LarryVan-engin/PJC_MIC/FOX M4 Possible Update (Hardware).drawio.pdf

IC mạch sạc (X) Single-cell Li-ion charger Sạc pin receiver qua USB-C

Pin Li Po 5000 mAh

Cổng sạc USB C 5V

MCU ESP32 (X) Bluetooth audio SoC / DSP processor MCU phụ xử lý Bluetooth audio, DSP, ....

MCU ESP32P4 Bluetooth audio SoC / DSP processor MCU chính xử lý DSP, mix, control

trung tâm

IC UHF #1 (X)
IC cho wireless microphone/UHF audio UHF FM demodulator, compandor/expander, squelch, audio output

IC UHF #2 (X)
IC cho wireless microphone/UHF audio UHF FM demodulator, compandor/expander, squelch, audio output

Khối nguồn

Power Source +3v3

MICROPHONE TX CH1 | MICROPHONE TX CH2

UHF RF

audio analog

UHF RF

Khối xử lý đầu vào từ 2 Microphone

IC Summing + Buffering (X) LM358-class dual op-amp Summing và Buffering 2 kênh audio từ KT065x

Power Source +3v3 | Kênh giao tiếp MCU #2

audio analog

BT A2DP BR/EDR

Khối xử lý bluetooth/ Hiển thị/ Nút bấm

Power Source +3v3

Bus giao tiếp với MCU ESP32P4

Thiết bị kết nối bluetooth (Điện thoại/ Máy tính bảng/ Laptop,...)

Khối xử lý đầu ra

Power Source +3v3

IC GAIN #1 (X) 3-Vrms cap-less line driver Driver output analog cho các cổng out (6.5mm, 3.5mm, XLR)

IC GAIN #2 (X) 3-Vrms cap-less line driver Driver output analog cho các cổng out (6.5mm, 3.5mm, XLR) Khối xử lý XLR

TS 6.35mm | AUX 3.5mm

Kênh giao tiếp MCU #2

Mode button Back Button ON/OFF Button

Encoder
(nút volume)

LCD Driver (X) LCD segment driver Drive LCD hiển thị

OLED module

Bus giao tiếp với MCU ESP32P4

Nút chọn channel 1 Nút chọn channel 2 Nút chọn channel 3 Nút chọn channel 4

SD Card
(Lưu file nhạc dưới dạng mp3 để phát)

Lưu ý: 1. Đây là sơ đồ khối các component nâng cấp, thay đổi trong phiên bản mới. 2. Các chỗ đánh dấu (X) là các IC chưa chọn để đưa vào, có thể sử dụng cùng loại với version trước. 3. khối XLR sẽ được thiết kế sau (hiện tại chỉ tham khảo).

SDMMC

Các cập nhật mới: 1. Thay đổi MCU, chuyển từ 2 con MV Silicon BP1548 sang MCU ESP32 (phụ, xử lý kết nối bluetooth) và MCU ESP32P4 Dual Core (chính, xử lý DSP). 2. Thay đổi nâng cấp mạch nguồn, sử dụng PIN 5000 mAh thay cho pin 3400 mAh cũ. 3. Nâng cấp OLED rộng hơn, có cảm ứng, đóng vai trò điều khiển thay vì chỉ hiển thị như phiên bản cũ. 4. Cập nhật các nút bấm mới, vẫn giữ như yêu cầu của khách hàng đề phòng trường hợp cảm ứng hư thì người dùng cũng có thể sử dụng được. 5. Thêm khe cắm SD card để có thể stream nhạc từ SD card. 6. Nâng cấp ra cả 3 chân AUX 3.5mm, TS 6.35mm và XLR.

Khối xử lý XLR

IC GAIN #3 (X) 3-Vrms cap-less line driver Driver output analog cho các cổng out (6.5mm, 3.5mm, RAC)

XLR Female 3-pin

Power Source +3v3

IC Balanced Driver (X) DRV134 hoặc THAT1646 Chuyển single-ended → differential.
