LarryVan-engin/PJC_MIC/FOX_M4_Block_Diagram.drawio.pdf

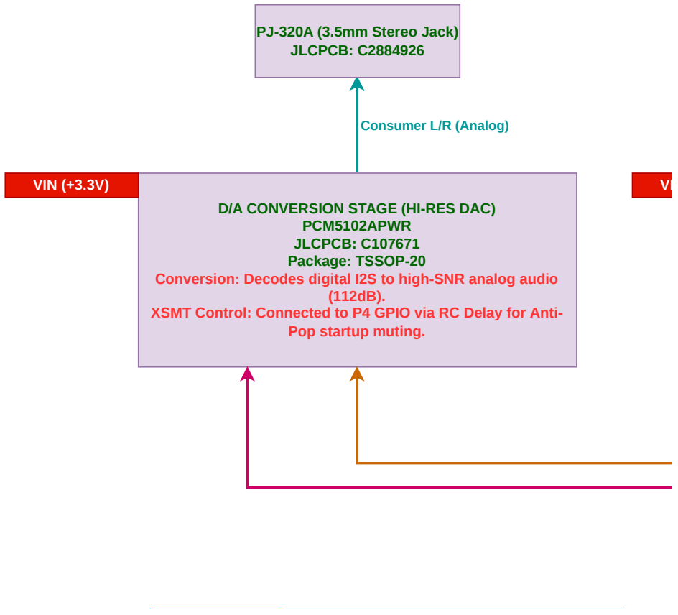
[picture p1: figure]
Consumer L/R (Analog); D/A CONVERSION STAGE (HI-RES DAC) PCM5102APWR JLCPCB: C107671 Package: TSSOP-20; Pop startup muting.; VIN (+3.3V); PJ-320A (3.5mm Stereo Jack) JLCPCB: C2884926

Conversion: Decodes digital I2S to high-SNR analog audio

XSMT Control: Connected to P4 GPIO via RC Delay for Anti-

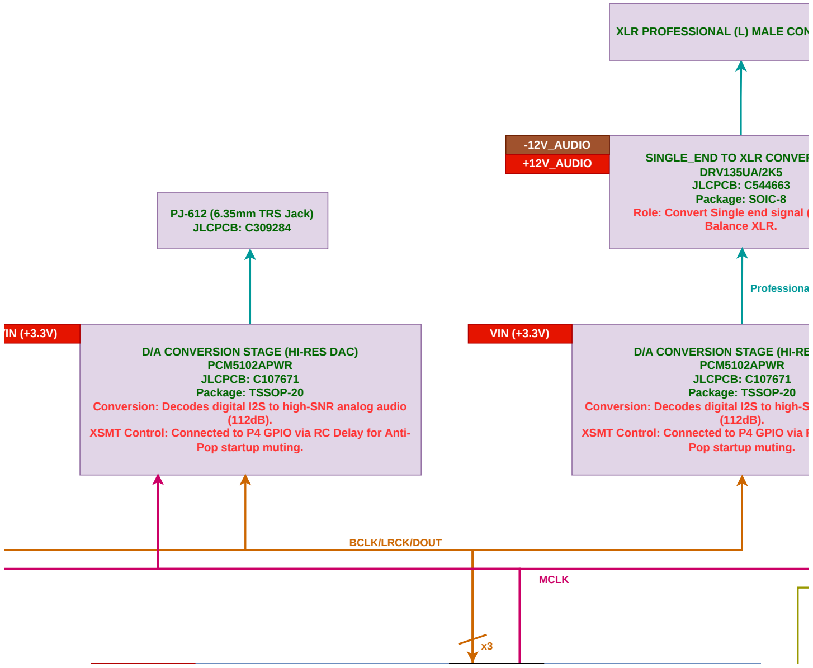
[picture p2: figure]
D/A CONVERSION STAGE (HI-RES DAC) PCM5102APWR JLCPCB: C107671 Package: TSSOP-20; Pop startup muting.; D/A CONVERSION STAGE (HI-RE PCM5102APWR JLCPCB: C107671 Package: TSSOP-20; VIN (+3.3V); PJ-612 (6.35mm TRS Jack) JLCPCB: C309284; SINGLE_END TO XLR CONVER DRV135UA/2K5 JLCPCB: C544663 Package: SOIC-8 Role: Convert Single end signal ( Balance XLR.; XLR PROFESSIONAL (L) MALE CON; Professiona; BCLK/LRCK/DOUT; MCLK; -12V_AUDIO +12V_AUDIO

Conversion: Decodes digital I2S to high-SNR analog audio

XSMT Control: Connected to P4 GPIO via RC Delay for Anti-

Conversion: Decodes digital I2S to high-S

XSMT Control: Connected to P4 GPIO via R

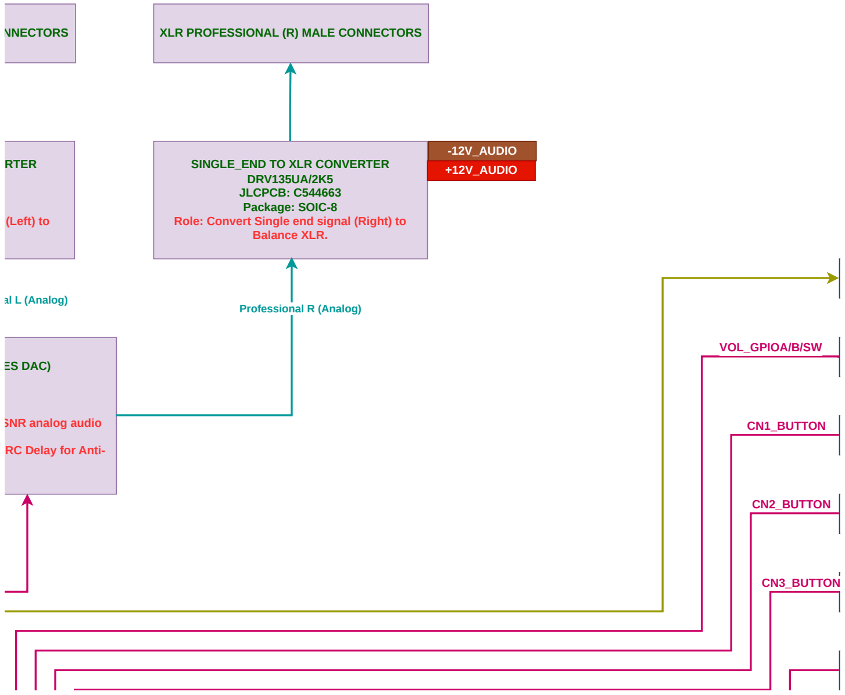
[picture p3: figure]
ES DAC); SNR analog audio; RC Delay for Anti-; RTER; (Left) to; NNECTORS; al L (Analog); VOL_GPIOA/B/SW; CN1_BUTTON; CN2_BUTTON; CN3_BUTTON; SINGLE_END TO XLR CONVERTER DRV135UA/2K5 JLCPCB: C544663 Package: SOIC-8; Balance XLR.; XLR PROFESSIONAL (R) MALE CONNECTORS; Professional R (Analog); -12V_AUDIO +12V_AUDIO

Role: Convert Single end signal (Right) to

SPI LCD Display 1.8 inch

Volume Button (Rotary Encoder)

Channel 1 button

Channel 2 button

Channel 3 button

Channel 4 button

VIN (+3.3V)

VIN (+3.3V)

VIN (+3.3V)

VIN (+3.3V)

VIN (+3.3V)

VIN (+3.3V)

SIGNAL LEGEND:

I2S (Audio Digital)

UART/USB (inter-MCU command)

Analog audio

Power rail

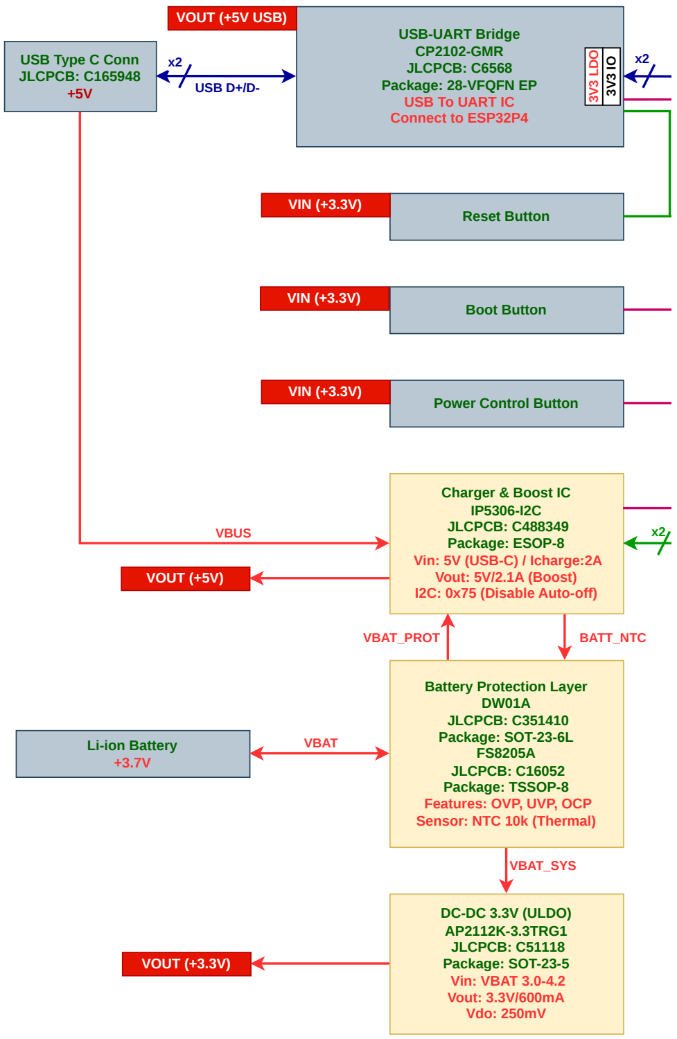
[picture p4: figure]
BATT_NTC; Charger & Boost IC IP5306-I2C JLCPCB: C488349 Package: ESOP-8 Vin: 5V (USB-C) / Icharge:2A Vout: 5V/2.1A (Boost) I2C: 0x75 (Disable Auto-off); DC-DC 3.3V (ULDO) AP2112K-3.3TRG1 JLCPCB: C51118 Package: SOT-23-5 Vin: VBAT 3.0-4.2 Vout: 3.3V/600mA Vdo: 250mV; VBAT_PROT; VBAT_SYS; Battery Protection Layer DW01A JLCPCB: C351410 Package: SOT-23-6L FS8205A JLCPCB: C16052 Package: TSSOP-8 Features: OVP, UVP, OCP Sensor: NTC 10k (Thermal); USB-UART Bridge CP2102-GMR JLCPCB: C6568 Package: 28-VFQFN EP USB To UART IC Connect to ESP32P4; VBUS; USB Type C Conn JLCPCB: C165948 +5V; Reset Button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

SPI (flash, display)

GPIO / interrupt

RF (UHF wireless)

I2C (control)

5V to 12V Rail
TPS65131RGER
JLCPCB: C87663
Package: QFN-24
Vin: +5V0
Vout: + 12V0

VOUT (+5V)

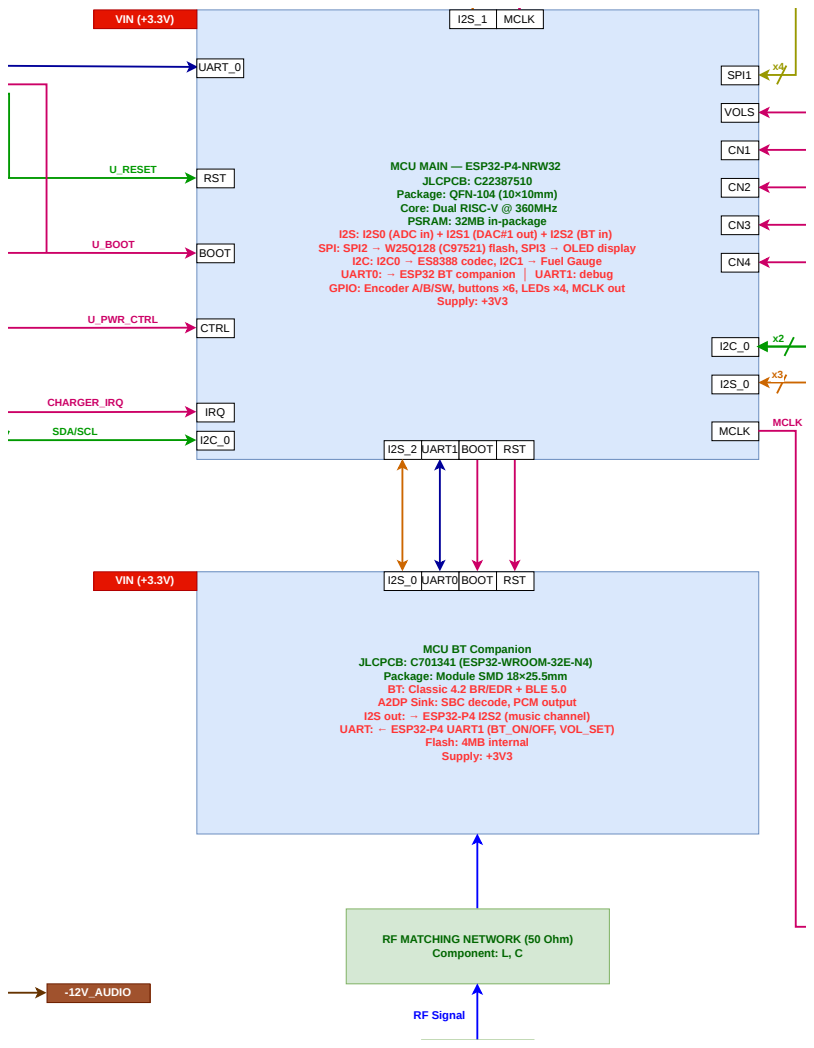
[picture p5: page 8]
Supply: +3V3; Flash: 4MB internal Supply: +3V3; I2S_2 UART1 BOOT RST; I2S_0 UART0 BOOT RST; U_RESET; U_BOOT; U_PWR_CTRL; SDA/SCL; -12V_AUDIO; CTRL; BOOT; RST; CHARGER_IRQ; IRQ; UART_0; MCLK; Component: L, C; RF Signal; SPI1; VOLS; VIN (+3.3V)

MCU MAIN — ESP32-P4-NRW32
JLCPCB: C22387510
Package: QFN-104 (10×10mm)
Core: Dual RISC-V @ 360MHz
PSRAM: 32MB in-package

I2S: I2S0 (ADC in) + I2S1 (DAC#1 out) + I2S2 (BT in)
SPI: SPI2 → W25Q128 (C97521) flash, SPI3 → OLED display
I2C: I2C0 → ES8388 codec, I2C1 → Fuel Gauge
UART0: → ESP32 BT companion │ UART1: debug
GPIO: Encoder A/B/SW, buttons ×6, LEDs ×4, MCLK out

MCU BT Companion

JLCPCB: C701341 (ESP32-WROOM-32E-N4)
Package: Module SMD 18×25.5mm
BT: Classic 4.2 BR/EDR + BLE 5.0
A2DP Sink: SBC decode, PCM output
I2S out: → ESP32-P4 I2S2 (music channel)
UART: ← ESP32-P4 UART1 (BT_ON/OFF, VOL_SET)

RF MATCHING NETWORK (50 Ohm)

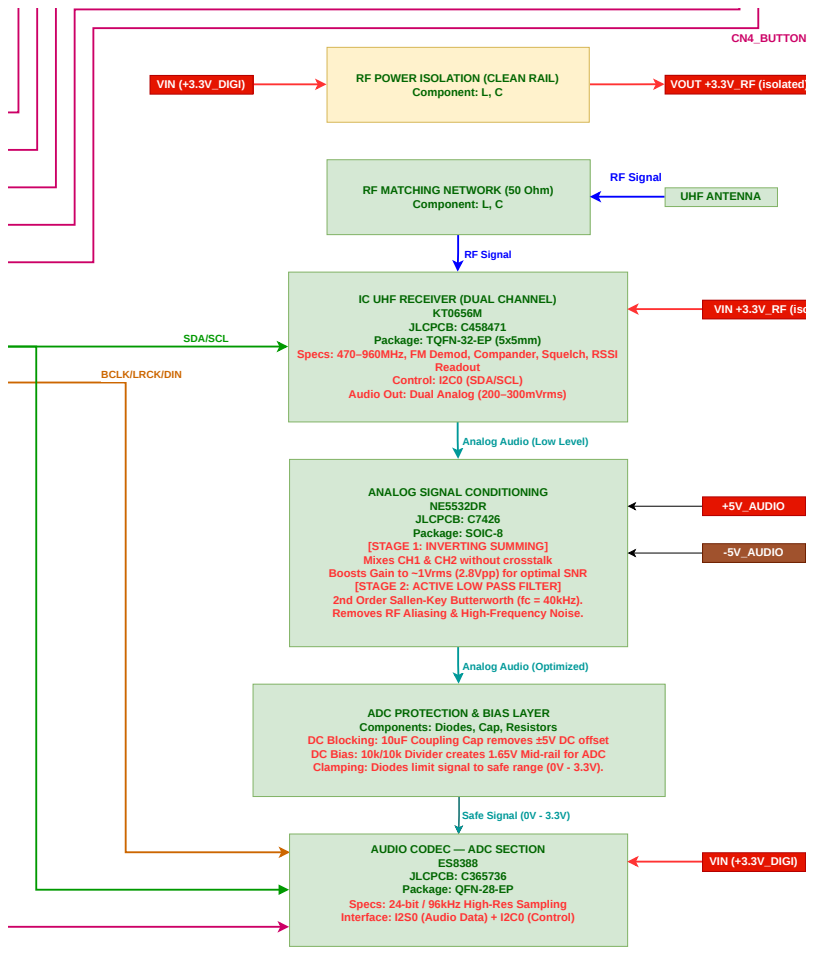
[picture p6: page 9]
Component: L, C; VIN (+3.3V_DIGI); VOUT +3.3V_RF (isolated); RF Signal; UHF ANTENNA; KT0656M JLCPCB: C458471 Package: TQFN-32-EP (5x5mm); Readout; VIN +3.3V_RF (iso; SDA/SCL; NE5532DR JLCPCB: C7426 Package: SOIC-8; Safe Signal (0V - 3.3V); +5V_AUDIO; -5V_AUDIO; ES8388 JLCPCB: C365736 Package: QFN-28-EP; CN4_BUTTON

RF POWER ISOLATION (CLEAN RAIL)

RF MATCHING NETWORK (50 Ohm)

IC UHF RECEIVER (DUAL CHANNEL)

Specs: 470–960MHz, FM Demod, Compander, Squelch, RSSI

BCLK/LRCK/DIN

Control: I2C0 (SDA/SCL)

Audio Out: Dual Analog (200–300mVrms)

Analog Audio (Low Level)

ANALOG SIGNAL CONDITIONING

[STAGE 1: INVERTING SUMMING]
Mixes CH1 & CH2 without crosstalk
Boosts Gain to ~1Vrms (2.8Vpp) for optimal SNR
[STAGE 2: ACTIVE LOW PASS FILTER]
2nd Order Sallen-Key Butterworth (fc = 40kHz).
Removes RF Aliasing & High-Frequency Noise.

Analog Audio (Optimized)

ADC PROTECTION & BIAS LAYER
Components: Diodes, Cap, Resistors

DC Blocking: 10uF Coupling Cap removes ±5V DC offset
DC Bias: 10k/10k Divider creates 1.65V Mid-rail for ADC
Clamping: Diodes limit signal to safe range (0V - 3.3V).

AUDIO CODEC — ADC SECTION

Specs: 24-bit / 96kHz High-Res Sampling
Interface: I2S0 (Audio Data) + I2C0 (Control)

d)

olated)

Vout: +-12V0
Fsw: 250 kHz (Fixed)
Type: Charge Pump Inverter

BLE ANTENNA
+12V_AUDIO
