LarryVan-engin/PJC_MIC/Fox M4.pdf

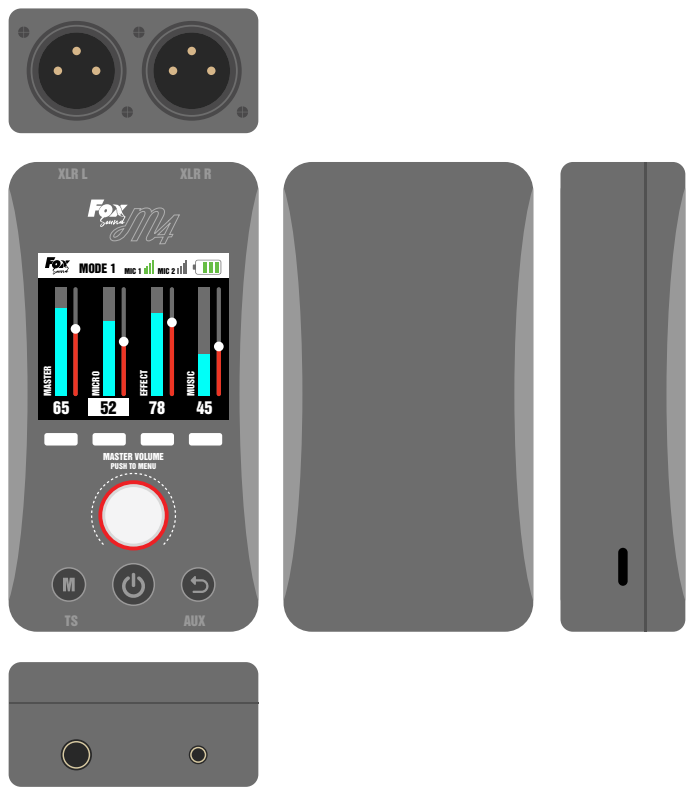
[picture p7: page 1]
MASTER; MICRO; EFFECT; MUSIC; MODE 1 MIC 1; MIC 2; XLR L; XLR R; AUX

MASTER VOLUME
PUSH TO MENU

MASTER
MODE:
HIGH:
MID:
LOW:
FBX:
SAVE:
RECALL:
FACTORY RESET

POP
+5
-2
+3
ON
MODE 1
MODE 1

MASTER
MODE:
HIGH:
MID:
LOW:
FBX:
SAVE:
RECALL:
FACTORY RESET

POP
+5
-2
+3
ON
MODE 1
MODE 1

MASTER

Would you like to save it? YES NO

Paring micro...

MICRO
MICRO 1 VOL:
MICRO 2 VOL:
COMPRESSOR:
NOSIE GATE:
LOW CUT:
HIGH CUT:
HIGH:
MID:

0
0
12%
-60dB
80Hz
12kHz
+3
0

EFFECT
ECHO VOL:
PRE DELAY:
DELAY:
REPEAT:
REVERB VOL:
REVERB TIME:
HIGH CUT:
LOW CUT:

85
15ms
230ms
57%
35
3260ms
10kHz
120Hz

EFFECT
ECHO VOL:
PRE DELAY:
DELAY:
REPEAT:
REVERB VOL:
REVERB TIME:
HIGH CUT:
LOW CUT:

85
15ms
230ms
57%
35
3260ms
10kHz
120Hz

MUSIC
STYLE:
HIGH:
MID:
LOW:
BLUETOOTH:

POP
+3
-3
0
ON

MUSIC
STYLE:
HIGH:
MID:
LOW:
BLUETOOTH:

POP
+3
-3
0
ON
MICRO | MICRO
LOW:
FBX EQ:
FBX EQ GAIN:
DUCKER:
IR MICRO

-3
11.100Hz
0
OFF

### MASTER

# ĐÂY LÀ MENU BÊN TRONG CỦA TỪNG KÊNH

### MICRO

### EFFECT

### MUSIC

POP
ACOUSTIC
DANCE/ DJ

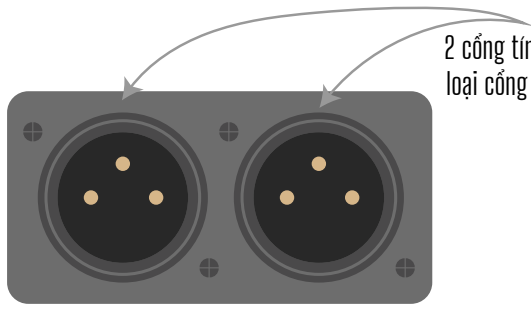
[picture p8: figure]
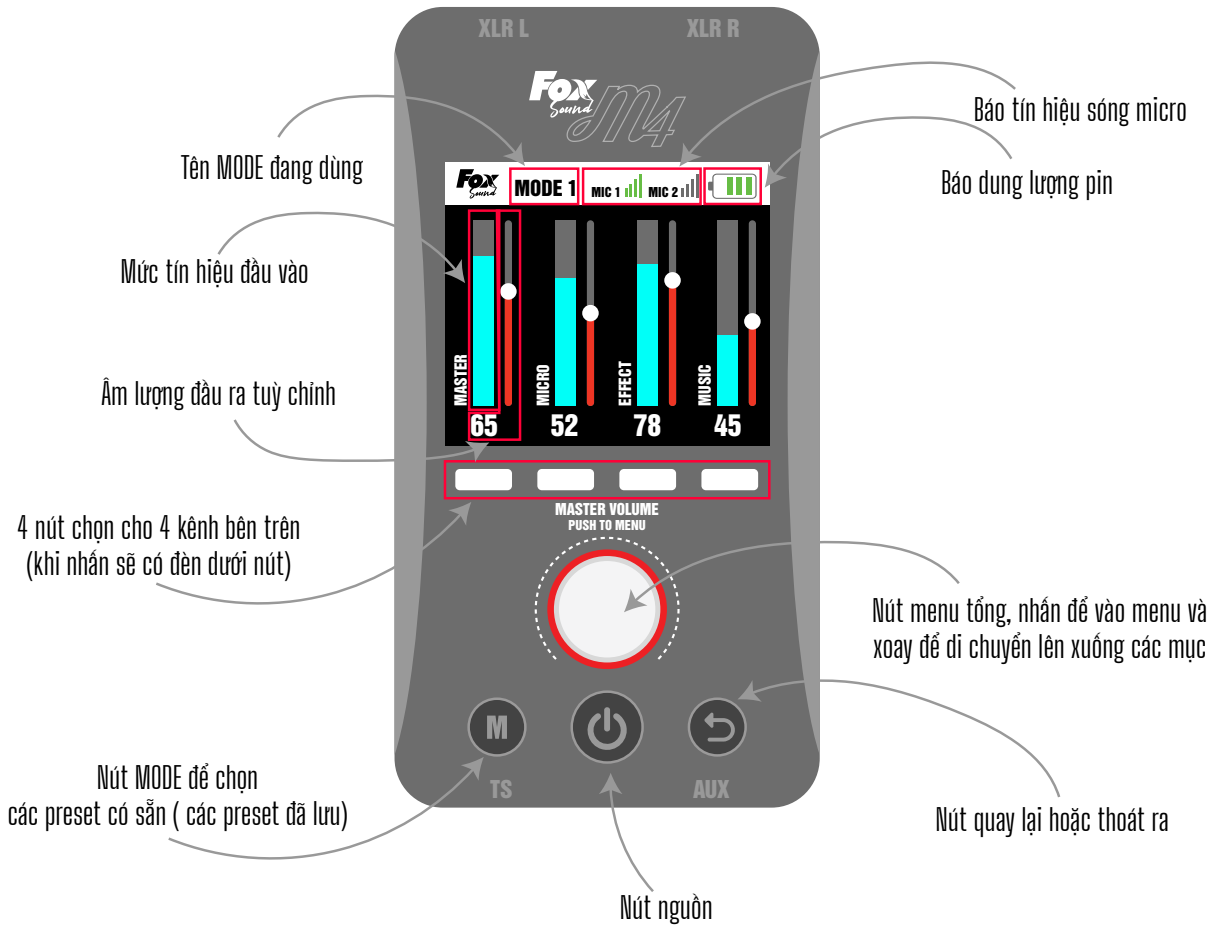
[picture p9: figure]
MASTER; MICRO; EFFECT; MUSIC; MODE 1 MIC 1; MIC 2; XLR L; XLR R; AUX; MASTER VOLUME PUSH TO MENU; Nút menu tổng, nhấn để vào menu và xoay để di chuyển lên xuống các mục; Báo dung lượng pin; Báo tín hiệu sóng micro; Tên MODE đang dùng; Mức tín hiệu đầu vào; Âm lượng đầu ra tuỳ chỉnh; Nút quay lại hoặc thoát ra; Nút nguồn; 4 nút chọn cho 4 kênh bên trên (khi nhấn sẽ có đèn dưới nút); Nút MODE để chọn các preset có sẵn ( các preset đã lưu)
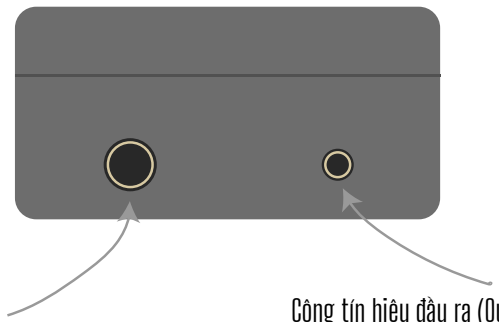
[picture p10: figure]

# YÊU CẦU VỀ TÍNH NĂNG BÊN TRONG:

2 cổng tín hiệu đầu ra ( Output ), loại cổng XLR Femail ( Canon Cái)

### 1/ THỜI LƯỢNG PIN CỦA ĐẦU THU KHOẢNG 8 TIẾNG/ THỜI GIAN SẠC KHOẢNG 3 TIẾNG

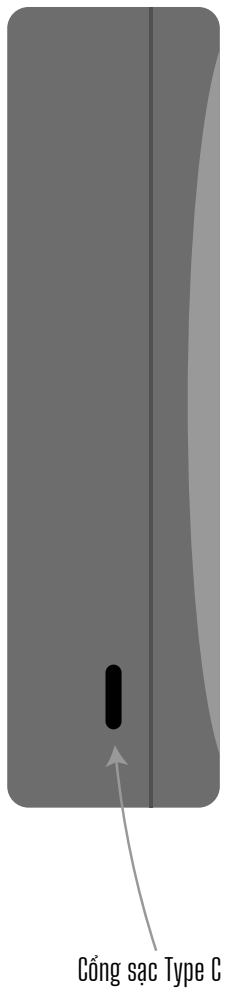
[picture p11: figure]
Cổng sạc Type C

2/ CÓ CÔNG NGHỆ CHỐNG HÚ, COMPRESOR (BỘ NÉN), DUCKER, NOISE GATE (CHỐNG NHIỄU) 3/ CÓ THỂ LƯU ĐƯỢC 8 PRESET LÀ CÁC THÔNG SỐ ĐÃ CHỈNH 4/ ĐIỀU CHỈNH ĐƯỢC DẢI ÂM BASS, MID , TREBLE CHO 4 KÊNH 5/ ĐẦU THU VÀ TAY MICRO SÓNG ỔN ĐỊNH TRỌNG PHẠM VI 30M 6/ KÊNH HIỆU ỨNG (EFFECT) CÓ ĐỦ CÁC HIỆU ỨNG ECHO, DELAY, REVERB 7/ DÒ TẦN SỐ ĐỂ KẾT NỐI LẠI MICRO KHI MICRO BỊ LỆCH TẦN SỐ SÓNG 8/ CÔNG NGHỆ BLUETOOTH 5.3 TRỞ LÊN 9/ MÀN HÌNH LCD ĐA ĐIỂM

Công tín hiệu đầu ra (Output), loại cổng: 6mm (TS Femail) Công tín hiệu đầu ra (Output), loại cổng: 3.5mm (AUX Femail)
