LarryVan-engin/PJC_MIC/LOG_ESP32_BLUETOOTH.md

I (85674) app_main: [CHK0 GPIO      ] BCK(26)=TOGGLE✓(0)  WS(25)=0  DOUT(5)=0
I (85674) app_main: [CHK1 A2DP→buf ] cb=0 KB  drop=0 B  L=0 R=0
I (85674) app_main: [CHK2 buf→I2S  ] recv=0 KB  sent=0 KB  short=0  err=0  last_err=ESP_OK(0x0)
W (85684) app_main:   ↳ No audio from BT stack — A2DP not streaming yet
I (90684) app_main: [CHK0 GPIO      ] BCK(26)=TOGGLE✓(0)  WS(25)=0  DOUT(5)=0
I (90684) app_main: [CHK1 A2DP→buf ] cb=0 KB  drop=0 B  L=0 R=0
I (90684) app_main: [CHK2 buf→I2S  ] recv=0 KB  sent=0 KB  short=0  err=0  last_err=ESP_OK(0x0)
W (90694) app_main:   ↳ No audio from BT stack — A2DP not streaming yet
I (95694) app_main: [CHK0 GPIO      ] BCK(26)=TOGGLE✓(0)  WS(25)=0  DOUT(5)=0
I (95694) app_main: [CHK1 A2DP→buf ] cb=0 KB  drop=0 B  L=0 R=0
I (95694) app_main: [CHK2 buf→I2S  ] recv=0 KB  sent=0 KB  short=0  err=0  last_err=ESP_OK(0x0)
W (95704) app_main:   ↳ No audio from BT stack — A2DP not streaming yet
ets Jul 29 2019 12:21:46

rst:0x1 (POWERON_RESET),boot:0x13 (SPI_FAST_FLASH_BOOT)
configsip: 0, SPIWP:0xee
clk_drv:0x00,q_drv:0x00,d_drv:0x00,cs0_drv:0x00,hd_drv:0x00,wp_drv:0x00
mode:DIO, clock div:2
load:0x3fff0040,len:6376
load:0x40078000,len:15900
ho 0 tail 12 room 4
load:0x40080400,len:3920
entry 0x40080644
I (29) boot: ESP-IDF v6.0-beta1-1452-g48e7e0618d-dir 2nd stage bootloader
I (29) boot: compile time May 16 2026 14:17:42
I (29) boot: Multicore bootloader
I (33) boot: chip revision: v3.1
I (36) boot.esp32: SPI Speed      : 40MHz
I (39) boot.esp32: SPI Mode       : DIO
I (43) boot.esp32: SPI Flash Size : 4MB
I (46) boot: Enabling RNG early entropy source...
I (51) boot: Partition Table:
I (53) boot: ## Label            Usage          Type ST Offset   Length
I (60) boot:  0 nvs              WiFi data        01 02 00009000 00006000
I (66) boot:  1 phy_init         RF data          01 01 0000f000 00001000
I (73) boot:  2 factory          factory app      00 00 00010000 00100000
I (79) boot: End of partition table
I (83) esp_image: segment 0: paddr=00010020 vaddr=3f400020 size=1ffbch (131004) map
I (137) esp_image: segment 1: paddr=0002ffe4 vaddr=3ffbdb60 size=00034h (    52) load
I (137) esp_image: segment 2: paddr=00030020 vaddr=400d0020 size=76614h (484884) map
I (313) esp_image: segment 3: paddr=000a663c vaddr=3ffbdb94 size=04ad8h ( 19160) load
I (321) esp_image: segment 4: paddr=000ab11c vaddr=40080000 size=15100h ( 86272) load
I (356) esp_image: segment 5: paddr=000c0224 vaddr=50000000 size=00028h (    40) load
I (367) boot: Loaded app from partition at offset 0x10000
I (368) boot: Disabling RNG early entropy source...
I (378) cpu_start: Multicore app
I (386) cpu_start: GPIO 3 and 1 are used as console UART I/O pins
I (387) cpu_start: Pro cpu start user code
I (387) cpu_start: cpu freq: 160000000 Hz
I (389) app_init: Application information:
I (392) app_init: Project name:     micro-fox-esp32-bluetooth
I (398) app_init: App version:      cd07e08-dirty
I (402) app_init: Compile time:     May 16 2026 16:30:55
I (407) app_init: ELF file SHA256:  e0705ec1c...
I (412) app_init: ESP-IDF:          v6.0-beta1-1452-g48e7e0618d-dir
I (418) efuse_init: Min chip rev:     v1.0
I (421) efuse_init: Max chip rev:     v3.99 
I (425) efuse_init: Chip rev:         v3.1
I (430) heap_init: Initializing. RAM available for dynamic allocation:
I (436) heap_init: At 3FFAFF10 len 000000F0 (0 KiB): DRAM
I (441) heap_init: At 3FFB6388 len 00001C78 (7 KiB): DRAM
I (446) heap_init: At 3FFB9A20 len 00004108 (16 KiB): DRAM
I (451) heap_init: At 3FFCAC30 len 000153D0 (84 KiB): DRAM
I (456) heap_init: At 3FFE0440 len 00003AE0 (14 KiB): D/IRAM
I (462) heap_init: At 3FFE4350 len 0001BCB0 (111 KiB): D/IRAM
I (467) heap_init: At 40095100 len 0000AF00 (43 KiB): IRAM
I (474) spi_flash: detected chip: generic
I (476) spi_flash: flash io: dio
I (480) coexist: coex firmware version: 093e3d2
I (484) main_task: Started on CPU0
I (494) main_task: Calling app_main()
I (494) fox-m4-bt: FOX M4 - ESP32 Bluetooth Companion starting...
I (494) app_main: Initializing Bluetooth Companion...
I (514) bsp_i2s: Initializing I2S Master Mode (BT drives BCK/WS)...
I (514) bt_sink: Initializing A2DP Sink: FOX-M4-AUDIO
I (514) BTDM_INIT: BT controller compile version [c28b205]
I (514) BTDM_INIT: Bluetooth MAC: 78:1c:3c:b7:d6:76
I (524) phy_init: phy_version 4863,a3a4459,Oct 28 2025,14:30:06
W (1124) BT_BTC: A2DP Enable without AVRC
I (1134) app_main: Bluetooth Companion Ready. Search for 'FOX-M4-AUDIO'
I (5514) app_main: [CHK0 GPIO      ] BCK(26)=TOGGLE✓(0)  WS(25)=0  DOUT(5)=0
I (5514) app_main: [CHK1 A2DP→buf ] cb=0 KB  drop=0 B  L=0 R=0
I (5514) app_main: [CHK2 buf→I2S  ] recv=0 KB  sent=0 KB  short=0  err=0  last_err=ESP_OK(0x0)
W (5524) app_main:   ↳ No audio from BT stack — A2DP not streaming yet
I (10524) app_main: [CHK0 GPIO      ] BCK(26)=TOGGLE✓(0)  WS(25)=0  DOUT(5)=0
I (10524) app_main: [CHK1 A2DP→buf ] cb=0 KB  drop=0 B  L=0 R=0
I (10524) app_main: [CHK2 buf→I2S  ] recv=0 KB  sent=0 KB  short=0  err=0  last_err=ESP_OK(0x0)
W (10534) app_main:   ↳ No audio from BT stack — A2DP not streaming yet
I (15534) app_main: [CHK0 GPIO      ] BCK(26)=TOGGLE✓(0)  WS(25)=0  DOUT(5)=0
I (15534) app_main: [CHK1 A2DP→buf ] cb=0 KB  drop=0 B  L=0 R=0
I (15534) app_main: [CHK2 buf→I2S  ] recv=0 KB  sent=0 KB  short=0  err=0  last_err=ESP_OK(0x0)
W (15544) app_main:   ↳ No audio from BT stack — A2DP not streaming yet
I (20544) app_main: [CHK0 GPIO      ] BCK(26)=TOGGLE✓(0)  WS(25)=0  DOUT(5)=0
I (20544) app_main: [CHK1 A2DP→buf ] cb=0 KB  drop=0 B  L=0 R=0
I (20544) app_main: [CHK2 buf→I2S  ] recv=0 KB  sent=0 KB  short=0  err=0  last_err=ESP_OK(0x0)
W (20554) app_main:   ↳ No audio from BT stack — A2DP not streaming yet
I (25554) app_main: [CHK0 GPIO      ] BCK(26)=TOGGLE✓(0)  WS(25)=0  DOUT(5)=0
I (25554) app_main: [CHK1 A2DP→buf ] cb=0 KB  drop=0 B  L=0 R=0
I (25554) app_main: [CHK2 buf→I2S  ] recv=0 KB  sent=0 KB  short=0  err=0  last_err=ESP_OK(0x0)
W (25564) app_main:   ↳ No audio from BT stack — A2DP not streaming yet
I (30564) app_main: [CHK0 GPIO      ] BCK(26)=TOGGLE✓(0)  WS(25)=0  DOUT(5)=0
I (30564) app_main: [CHK1 A2DP→buf ] cb=0 KB  drop=0 B  L=0 R=0
I (30564) app_main: [CHK2 buf→I2S  ] recv=0 KB  sent=0 KB  short=0  err=0  last_err=ESP_OK(0x0)
W (30574) app_main:   ↳ No audio from BT stack — A2DP not streaming yet
I (35574) app_main: [CHK0 GPIO      ] BCK(26)=TOGGLE✓(0)  WS(25)=0  DOUT(5)=0
I (35574) app_main: [CHK1 A2DP→buf ] cb=0 KB  drop=0 B  L=0 R=0
I (35574) app_main: [CHK2 buf→I2S  ] recv=0 KB  sent=0 KB  short=0  err=0  last_err=ESP_OK(0x0)
W (35584) app_main:   ↳ No audio from BT stack — A2DP not streaming yet
I (40584) app_main: [CHK0 GPIO      ] BCK(26)=TOGGLE✓(0)  WS(25)=0  DOUT(5)=0
I (40584) app_main: [CHK1 A2DP→buf ] cb=0 KB  drop=0 B  L=0 R=0
I (40584) app_main: [CHK2 buf→I2S  ] recv=0 KB  sent=0 KB  short=0  err=0  last_err=ESP_OK(0x0)
W (40594) app_main:   ↳ No audio from BT stack — A2DP not streaming yet
I (45594) app_main: [CHK0 GPIO      ] BCK(26)=TOGGLE✓(0)  WS(25)=0  DOUT(5)=0
I (45594) app_main: [CHK1 A2DP→buf ] cb=0 KB  drop=0 B  L=0 R=0
I (45594) app_main: [CHK2 buf→I2S  ] recv=0 KB  sent=0 KB  short=0  err=0  last_err=ESP_OK(0x0)
W (45604) app_main:   ↳ No audio from BT stack — A2DP not streaming yet
I (50604) app_main: [CHK0 GPIO      ] BCK(26)=TOGGLE✓(0)  WS(25)=0  DOUT(5)=0
I (50604) app_main: [CHK1 A2DP→buf ] cb=0 KB  drop=0 B  L=0 R=0
I (50604) app_main: [CHK2 buf→I2S  ] recv=0 KB  sent=0 KB  short=0  err=0  last_err=ESP_OK(0x0)
W (50614) app_main:   ↳ No audio from BT stack — A2DP not streaming yet
I (55614) app_main: [CHK0 GPIO      ] BCK(26)=TOGGLE✓(0)  WS(25)=0  DOUT(5)=0
I (55614) app_main: [CHK1 A2DP→buf ] cb=0 KB  drop=0 B  L=0 R=0
I (55614) app_main: [CHK2 buf→I2S  ] recv=0 KB  sent=0 KB  short=0  err=0  last_err=ESP_OK(0x0)
W (55624) app_main:   ↳ No audio from BT stack — A2DP not streaming yet
W (60184) BT_HCI: hcif conn complete: hdl 0x80, st 0x0
I (60184) bt_sink: ACL connected — waiting for A2DP profile
I (60624) app_main: [CHK0 GPIO      ] BCK(26)=TOGGLE✓(0)  WS(25)=0  DOUT(5)=0
I (60624) app_main: [CHK1 A2DP→buf ] cb=0 KB  drop=0 B  L=0 R=0
I (60624) app_main: [CHK2 buf→I2S  ] recv=0 KB  sent=0 KB  short=0  err=0  last_err=ESP_OK(0x0)
W (60634) app_main:   ↳ No audio from BT stack — A2DP not streaming yet
I (60634) bt_sink: Auth success: DESKTOP-V5SRC84
W (61374) BT_APPL: new conn_srvc id:19, app_id:0
I (61374) bt_sink: A2DP Connected
W (61384) BT_BTC: AVRC not Init, not using it.
I (61644) BT_LOG: bta_av_link_role_ok hndl:x41 role:1 conn_audio:x1 bits:1 features:x8400

W (61654) BT_APPL: new conn_srvc id:19, app_id:1
I (61654) bt_sink: A2DP Streaming Started
I (65634) app_main: [CHK0 GPIO      ] BCK(26)=TOGGLE✓(0)  WS(25)=0  DOUT(5)=1
I (65644) app_main: [CHK1 A2DP→buf ] cb=680 KB  drop=0 B  L=-79 R=-182
I (65644) app_main: [CHK2 buf→I2S  ] recv=678 KB  sent=678 KB  short=0  err=0  last_err=ESP_OK(0x0)
I (65654) app_main: [LINK TX ] BT Master TX active ✓ (slave confirmation is on P4 [LINK I2S])
I (65664) app_main:   ↳ Audio path OK on ESP32-BT side ✓
I (70664) app_main: [CHK0 GPIO      ] BCK(26)=TOGGLE✓(0)  WS(25)=0  DOUT(5)=1
I (70664) app_main: [CHK1 A2DP→buf ] cb=860 KB  drop=0 B  L=-21 R=-124
I (70664) app_main: [CHK2 buf→I2S  ] recv=864 KB  sent=864 KB  short=0  err=0  last_err=ESP_OK(0x0)
I (70674) app_main:   ↳ Audio path OK on ESP32-BT side ✓
I (75684) app_main: [CHK0 GPIO      ] BCK(26)=TOGGLE✓(0)  WS(25)=0  DOUT(5)=0
I (75684) app_main: [CHK1 A2DP→buf ] cb=860 KB  drop=0 B  L=0 R=-2
I (75684) app_main: [CHK2 buf→I2S  ] recv=864 KB  sent=864 KB  short=0  err=0  last_err=ESP_OK(0x0)
I (75694) app_main:   ↳ Audio path OK on ESP32-BT side ✓
I (80694) app_main: [CHK0 GPIO      ] BCK(26)=TOGGLE✓(0)  WS(25)=0  DOUT(5)=0
I (80694) app_main: [CHK1 A2DP→buf ] cb=860 KB  drop=0 B  L=336 R=-263
I (80694) app_main: [CHK2 buf→I2S  ] recv=862 KB  sent=862 KB  short=0  err=0  last_err=ESP_OK(0x0)
I (80704) app_main:   ↳ Audio path OK on ESP32-BT side ✓
I (85714) app_main: [CHK0 GPIO      ] BCK(26)=TOGGLE✓(0)  WS(25)=0  DOUT(5)=1
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
I (150994) app_main: [CHK1 A2DP→buf ] cb=0 KB  drop=0 B  L=0 R=0
I (150994) app_main: [CHK2 buf→I2S  ] recv=0 KB  sent=0 KB  short=0  err=0  last_err=ESP_OK(0x0)
W (151004) app_main: [LINK TX ] BT Master TX not active yet (no A2DP payload or I2S write issue)
W (151004) app_main:   ↳ No audio from BT stack — A2DP not streaming yet
I (156014) app_main: [CHK0 GPIO      ] BCK(26)=TOGGLE✓(0)  WS(25)=0  DOUT(5)=0
I (156014) app_main: [CHK1 A2DP→buf ] cb=0 KB  drop=0 B  L=0 R=0
I (156014) app_main: [CHK2 buf→I2S  ] recv=0 KB  sent=0 KB  short=0  err=0  last_err=ESP_OK(0x0)
W (156024) app_main:   ↳ No audio from BT stack — A2DP not streaming yet
I (161024) app_main: [CHK0 GPIO      ] BCK(26)=TOGGLE✓(0)  WS(25)=0  DOUT(5)=0
I (161024) app_main: [CHK1 A2DP→buf ] cb=0 KB  drop=0 B  L=0 R=0
I (161024) app_main: [CHK2 buf→I2S  ] recv=0 KB  sent=0 KB  short=0  err=0  last_err=ESP_OK(0x0)
W (161034) app_main:   ↳ No audio from BT stack — A2DP not streaming yet
I (166034) app_main: [CHK0 GPIO      ] BCK(26)=TOGGLE✓(0)  WS(25)=0  DOUT(5)=0
I (166034) app_main: [CHK1 A2DP→buf ] cb=0 KB  drop=0 B  L=0 R=0
I (166034) app_main: [CHK2 buf→I2S  ] recv=0 KB  sent=0 KB  short=0  err=0  last_err=ESP_OK(0x0)
W (166044) app_main:   ↳ No audio from BT stack — A2DP not streaming yet
W (167424) BT_HCI: hcif mode change: hdl 0x80, mode 0, intv 0, status 0x0
I (167424) BT_LOG: bta_av_link_role_ok hndl:x41 role:1 conn_audio:x1 bits:1 features:x8400

I (167434) bt_sink: A2DP Streaming Started
I (171044) app_main: [CHK0 GPIO      ] BCK(26)=TOGGLE✓(0)  WS(25)=0  DOUT(5)=1
I (171044) app_main: [CHK1 A2DP→buf ] cb=620 KB  drop=0 B  L=-695 R=-272
I (171044) app_main: [CHK2 buf→I2S  ] recv=618 KB  sent=618 KB  short=0  err=0  last_err=ESP_OK(0x0)
I (171054) app_main: [LINK TX ] BT Master TX active ✓ (slave confirmation is on P4 [LINK I2S])
I (171064) app_main:   ↳ Audio path OK on ESP32-BT side ✓
I (176074) app_main: [CHK0 GPIO      ] BCK(26)=TOGGLE✓(0)  WS(25)=0  DOUT(5)=0
I (176074) app_main: [CHK1 A2DP→buf ] cb=864 KB  drop=0 B  L=-256 R=-480
I (176074) app_main: [CHK2 buf→I2S  ] recv=866 KB  sent=866 KB  short=0  err=0  last_err=ESP_OK(0x0)
I (176084) app_main:   ↳ Audio path OK on ESP32-BT side ✓
I (181094) app_main: [CHK0 GPIO      ] BCK(26)=TOGGLE✓(0)  WS(25)=0  DOUT(5)=1
I (181094) app_main: [CHK1 A2DP→buf ] cb=860 KB  drop=0 B  L=-63 R=341
I (181094) app_main: [CHK2 buf→I2S  ] recv=864 KB  sent=864 KB  short=0  err=0  last_err=ESP_OK(0x0)
I (181104) app_main:   ↳ Audio path OK on ESP32-BT side ✓
I (186104) app_main: [CHK0 GPIO      ] BCK(26)=TOGGLE✓(0)  WS(25)=0  DOUT(5)=1
I (186104) app_main: [CHK1 A2DP→buf ] cb=864 KB  drop=0 B  L=-707 R=60
I (186114) app_main: [CHK2 buf→I2S  ] recv=864 KB  sent=864 KB  short=0  err=0  last_err=ESP_OK(0x0)
I (186124) app_main:   ↳ Audio path OK on ESP32-BT side ✓
I (191124) app_main: [CHK0 GPIO      ] BCK(26)=TOGGLE✓(0)  WS(25)=0  DOUT(5)=1
I (191124) app_main: [CHK1 A2DP→buf ] cb=860 KB  drop=0 B  L=424 R=-506
I (191124) app_main: [CHK2 buf→I2S  ] recv=864 KB  sent=864 KB  short=0  err=0  last_err=ESP_OK(0x0)
I (191134) app_main:   ↳ Audio path OK on ESP32-BT side ✓
I (196134) app_main: [CHK0 GPIO      ] BCK(26)=TOGGLE✓(0)  WS(25)=0  DOUT(5)=1
I (196134) app_main: [CHK1 A2DP→buf ] cb=860 KB  drop=0 B  L=-455 R=97
I (196144) app_main: [CHK2 buf→I2S  ] recv=864 KB  sent=864 KB  short=0  err=0  last_err=ESP_OK(0x0)
I (196154) app_main:   ↳ Audio path OK on ESP32-BT side ✓
I (201154) app_main: [CHK0 GPIO      ] BCK(26)=TOGGLE✓(0)  WS(25)=0  DOUT(5)=0
I (201154) app_main: [CHK1 A2DP→buf ] cb=860 KB  drop=0 B  L=-252 R=-963
I (201154) app_main: [CHK2 buf→I2S  ] recv=864 KB  sent=864 KB  short=0  err=0  last_err=ESP_OK(0x0)
I (201164) app_main:   ↳ Audio path OK on ESP32-BT side ✓
I (206164) app_main: [CHK0 GPIO      ] BCK(26)=TOGGLE✓(0)  WS(25)=0  DOUT(5)=1
I (206164) app_main: [CHK1 A2DP→buf ] cb=860 KB  drop=0 B  L=148 R=297
I (206174) app_main: [CHK2 buf→I2S  ] recv=864 KB  sent=864 KB  short=0  err=0  last_err=ESP_OK(0x0)
I (206184) app_main:   ↳ Audio path OK on ESP32-BT side ✓
I (211184) app_main: [CHK0 GPIO      ] BCK(26)=TOGGLE✓(0)  WS(25)=0  DOUT(5)=0
I (211194) app_main: [CHK1 A2DP→buf ] cb=860 KB  drop=0 B  L=844 R=507
I (211194) app_main: [CHK2 buf→I2S  ] recv=864 KB  sent=864 KB  short=0  err=0  last_err=ESP_OK(0x0)
I (211204) app_main:   ↳ Audio path OK on ESP32-BT side ✓
I (216204) app_main: [CHK0 GPIO      ] BCK(26)=TOGGLE✓(0)  WS(25)=0  DOUT(5)=1
I (216204) app_main: [CHK1 A2DP→buf ] cb=860 KB  drop=0 B  L=-83 R=-771
I (216214) app_main: [CHK2 buf→I2S  ] recv=866 KB  sent=866 KB  short=0  err=0  last_err=ESP_OK(0x0)
I (216224) app_main:   ↳ Audio path OK on ESP32-BT side ✓
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
I (808384) app_main:   ↳ Audio path OK on ESP32-BT side ✓
I (813384) app_main: [CHK0 GPIO      ] BCK(26)=TOGGLE✓(0)  WS(25)=0  DOUT(5)=1
I (813384) app_main: [CHK1 A2DP→buf ] cb=860 KB  drop=0 B  L=-17 R=-383
I (813394) app_main: [CHK2 buf→I2S  ] recv=864 KB  sent=864 KB  short=0  err=0  last_err=ESP_OK(0x0)
I (813394) app_main:   ↳ Audio path OK on ESP32-BT side ✓
I (818404) app_main: [CHK0 GPIO      ] BCK(26)=TOGGLE✓(0)  WS(25)=0  DOUT(5)=0
I (818404) app_main: [CHK1 A2DP→buf ] cb=860 KB  drop=0 B  L=574 R=540
I (818404) app_main: [CHK2 buf→I2S  ] recv=864 KB  sent=864 KB  short=0  err=0  last_err=ESP_OK(0x0)
I (818414) app_main:   ↳ Audio path OK on ESP32-BT side ✓
