LarryVan-engin/PJC_MIC/FOX_M4_Prototype_v1.0.pdf

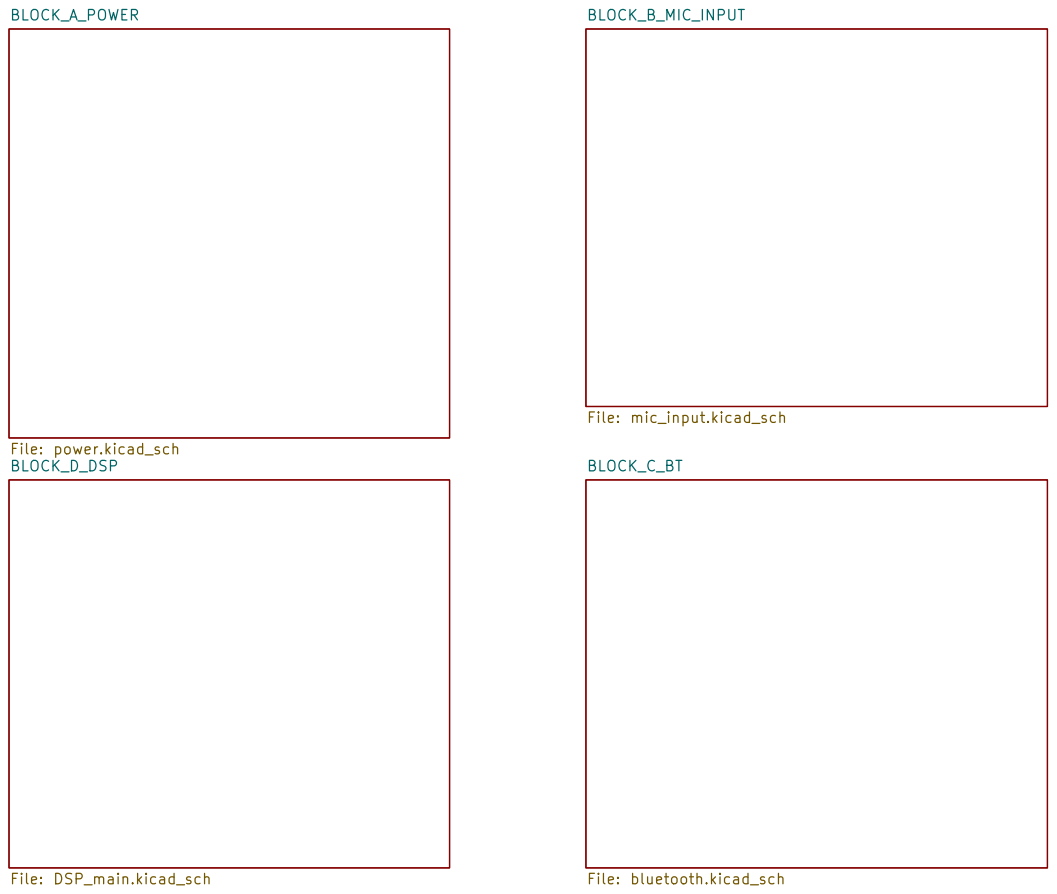
[picture p12: page 1]

Size: A4 | Rev:
KiCad E.D.A. 10.0.1 | Id: 1/5

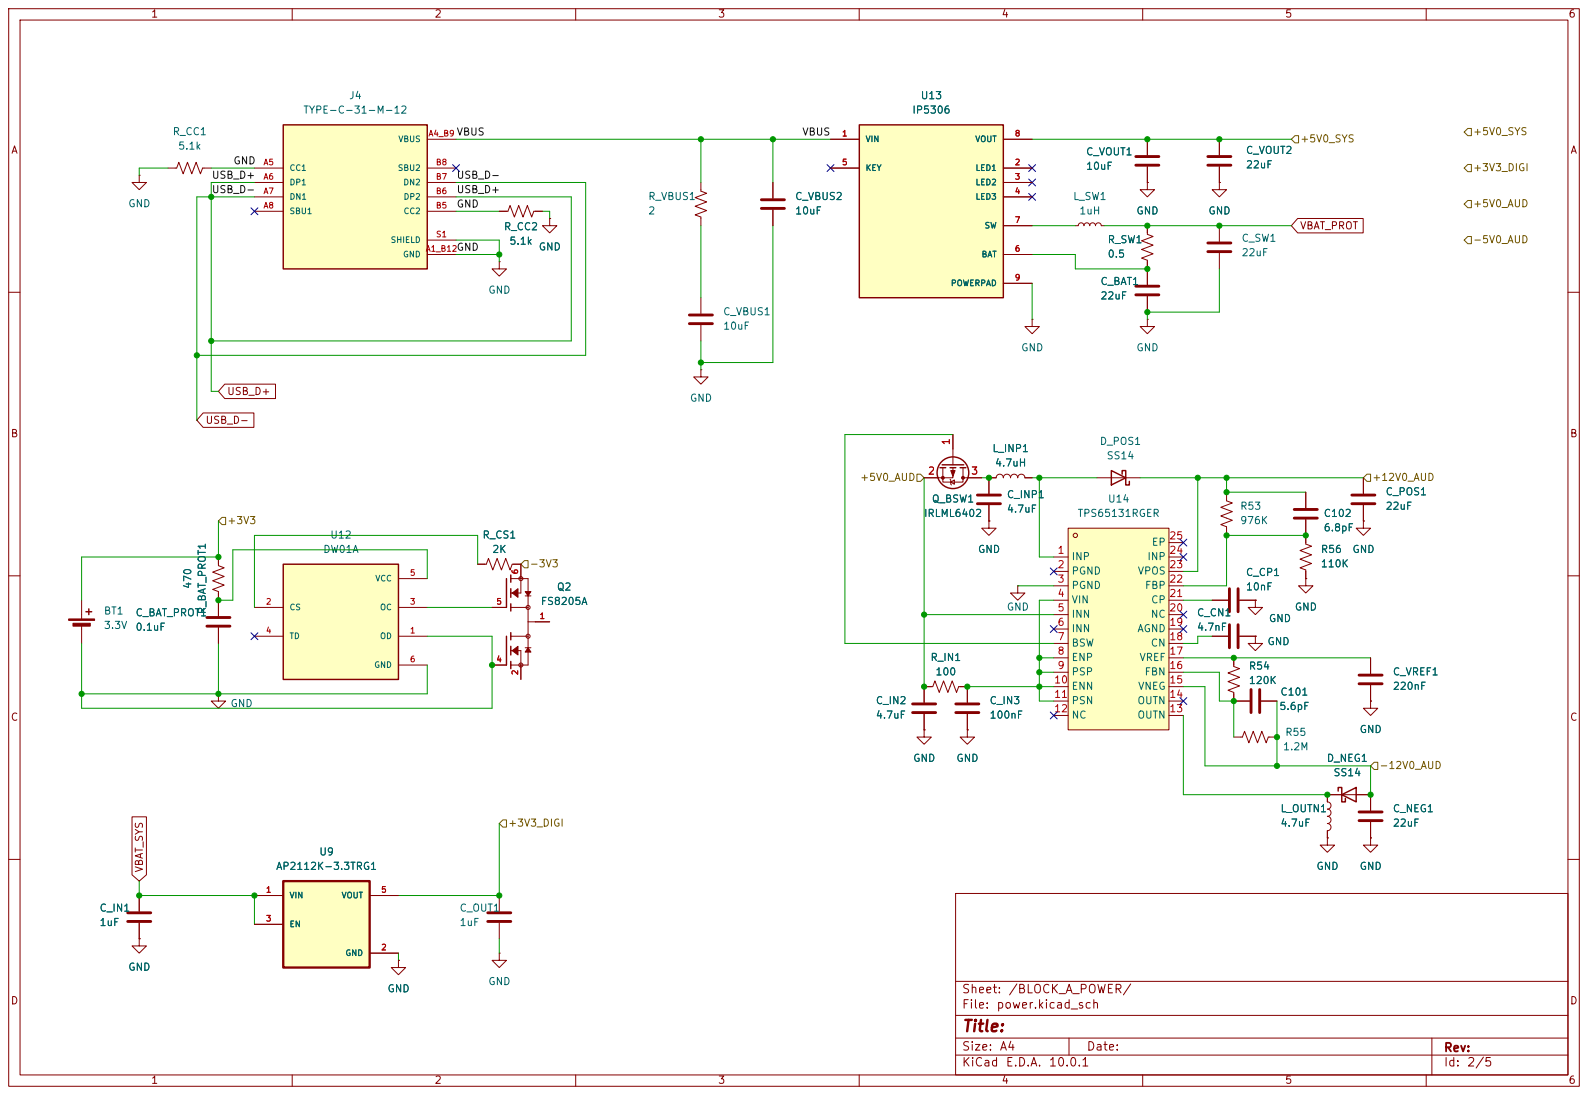
[picture p13: page 2]

INN 6 BSW 7

ENP 8 PSP 9

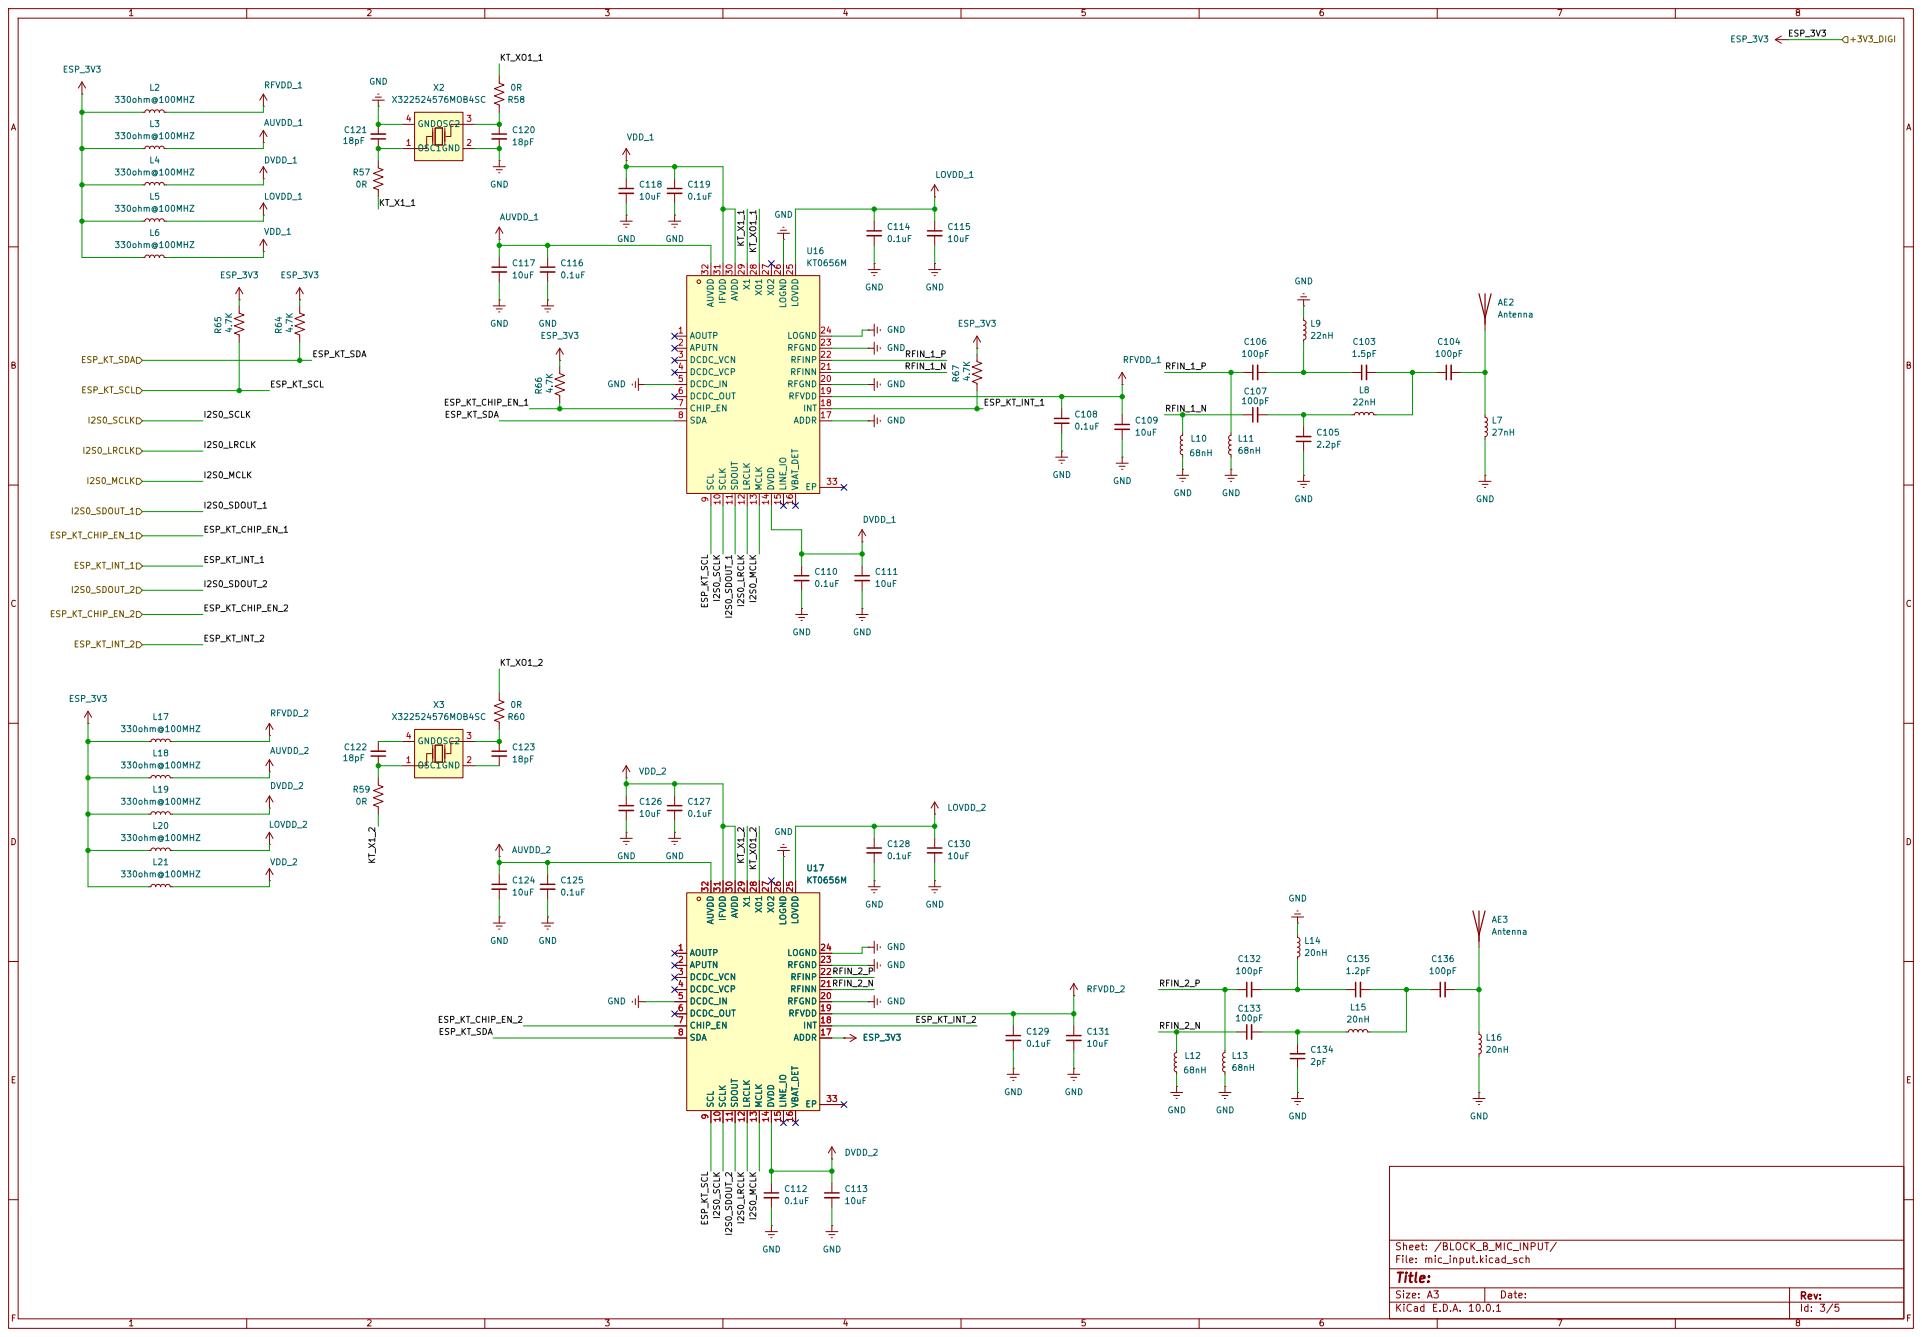
[picture p14: page 3]

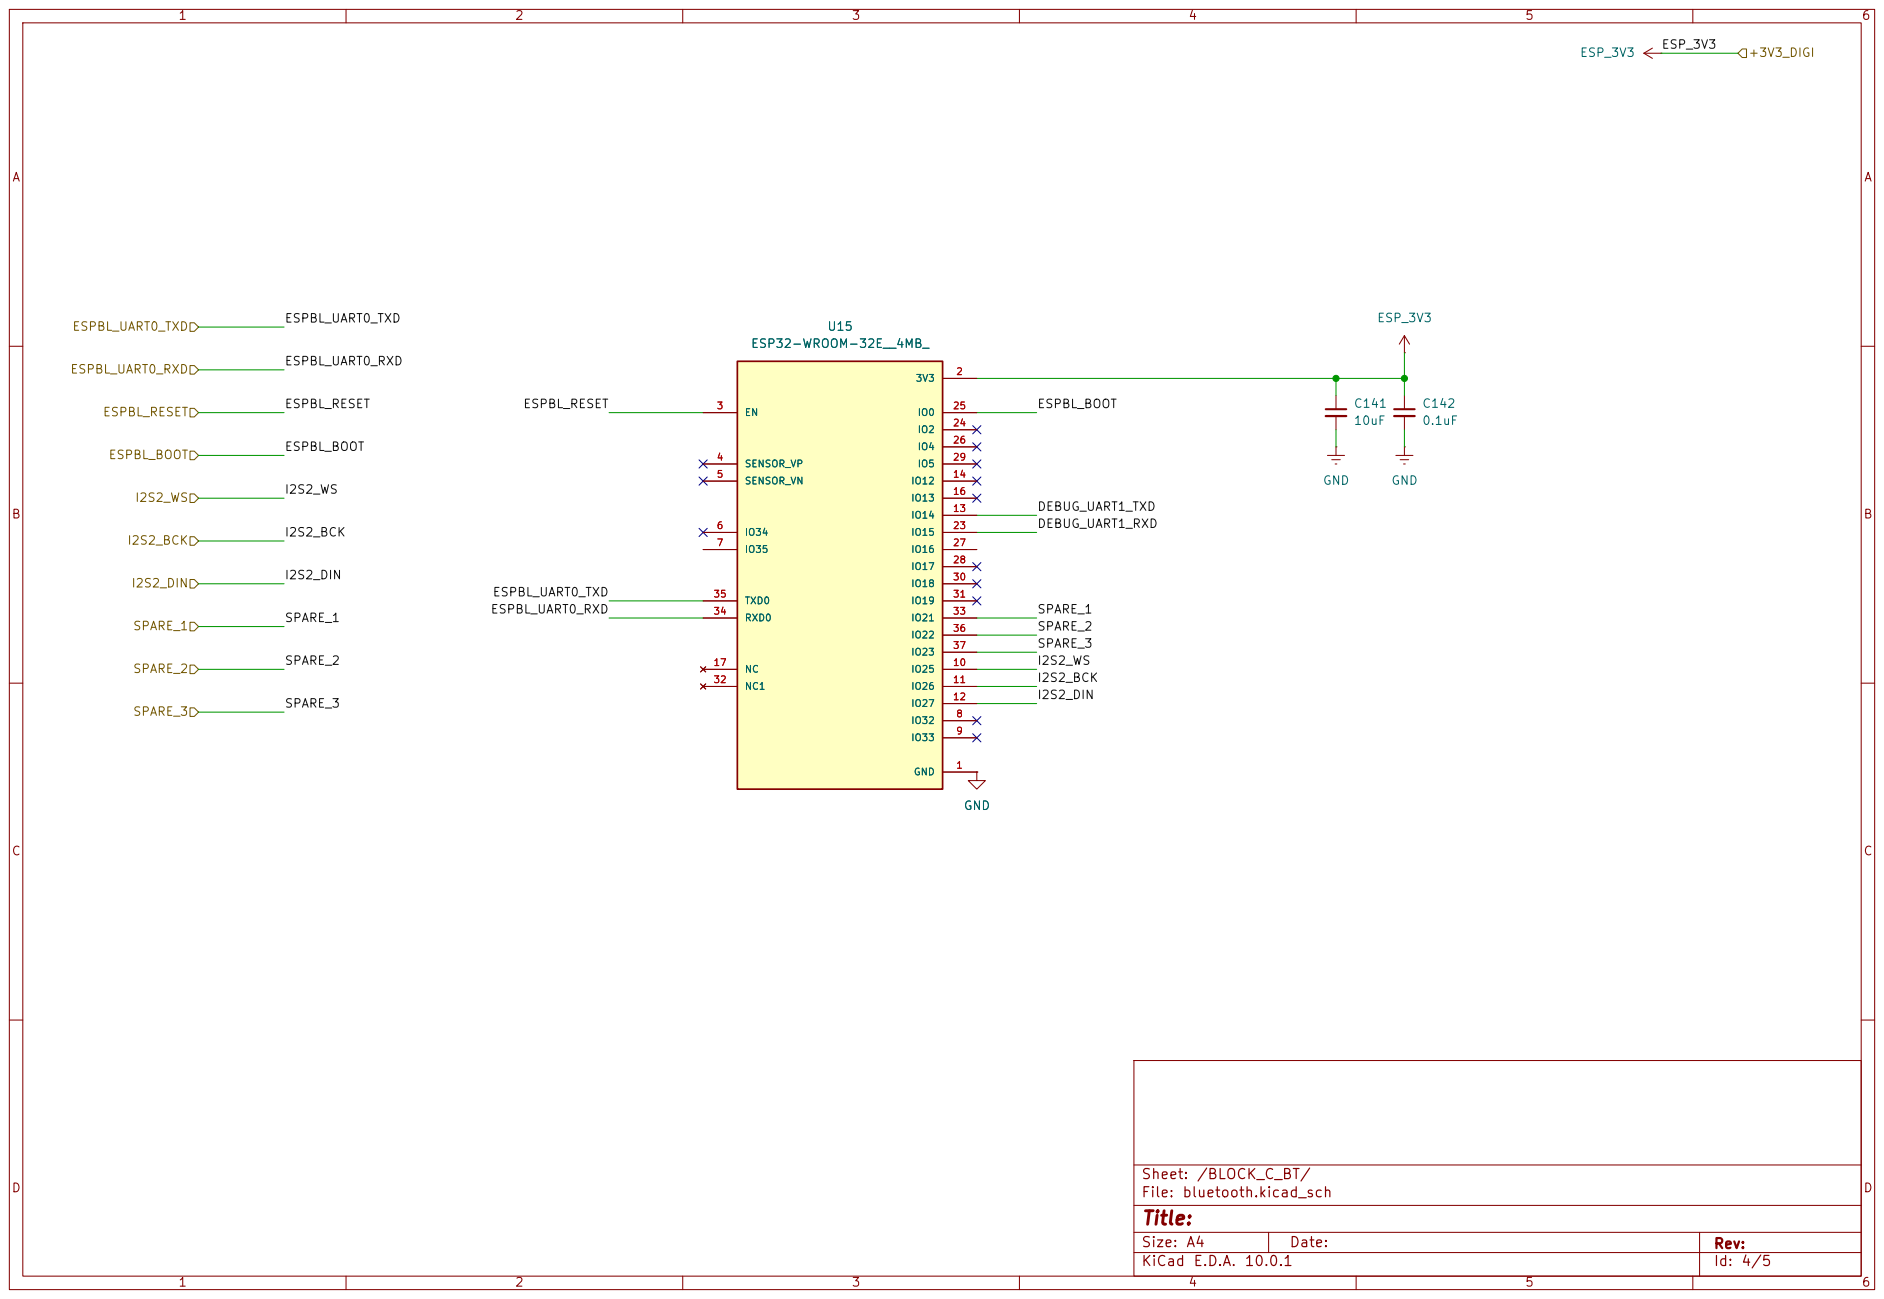
[picture p15: page 4]

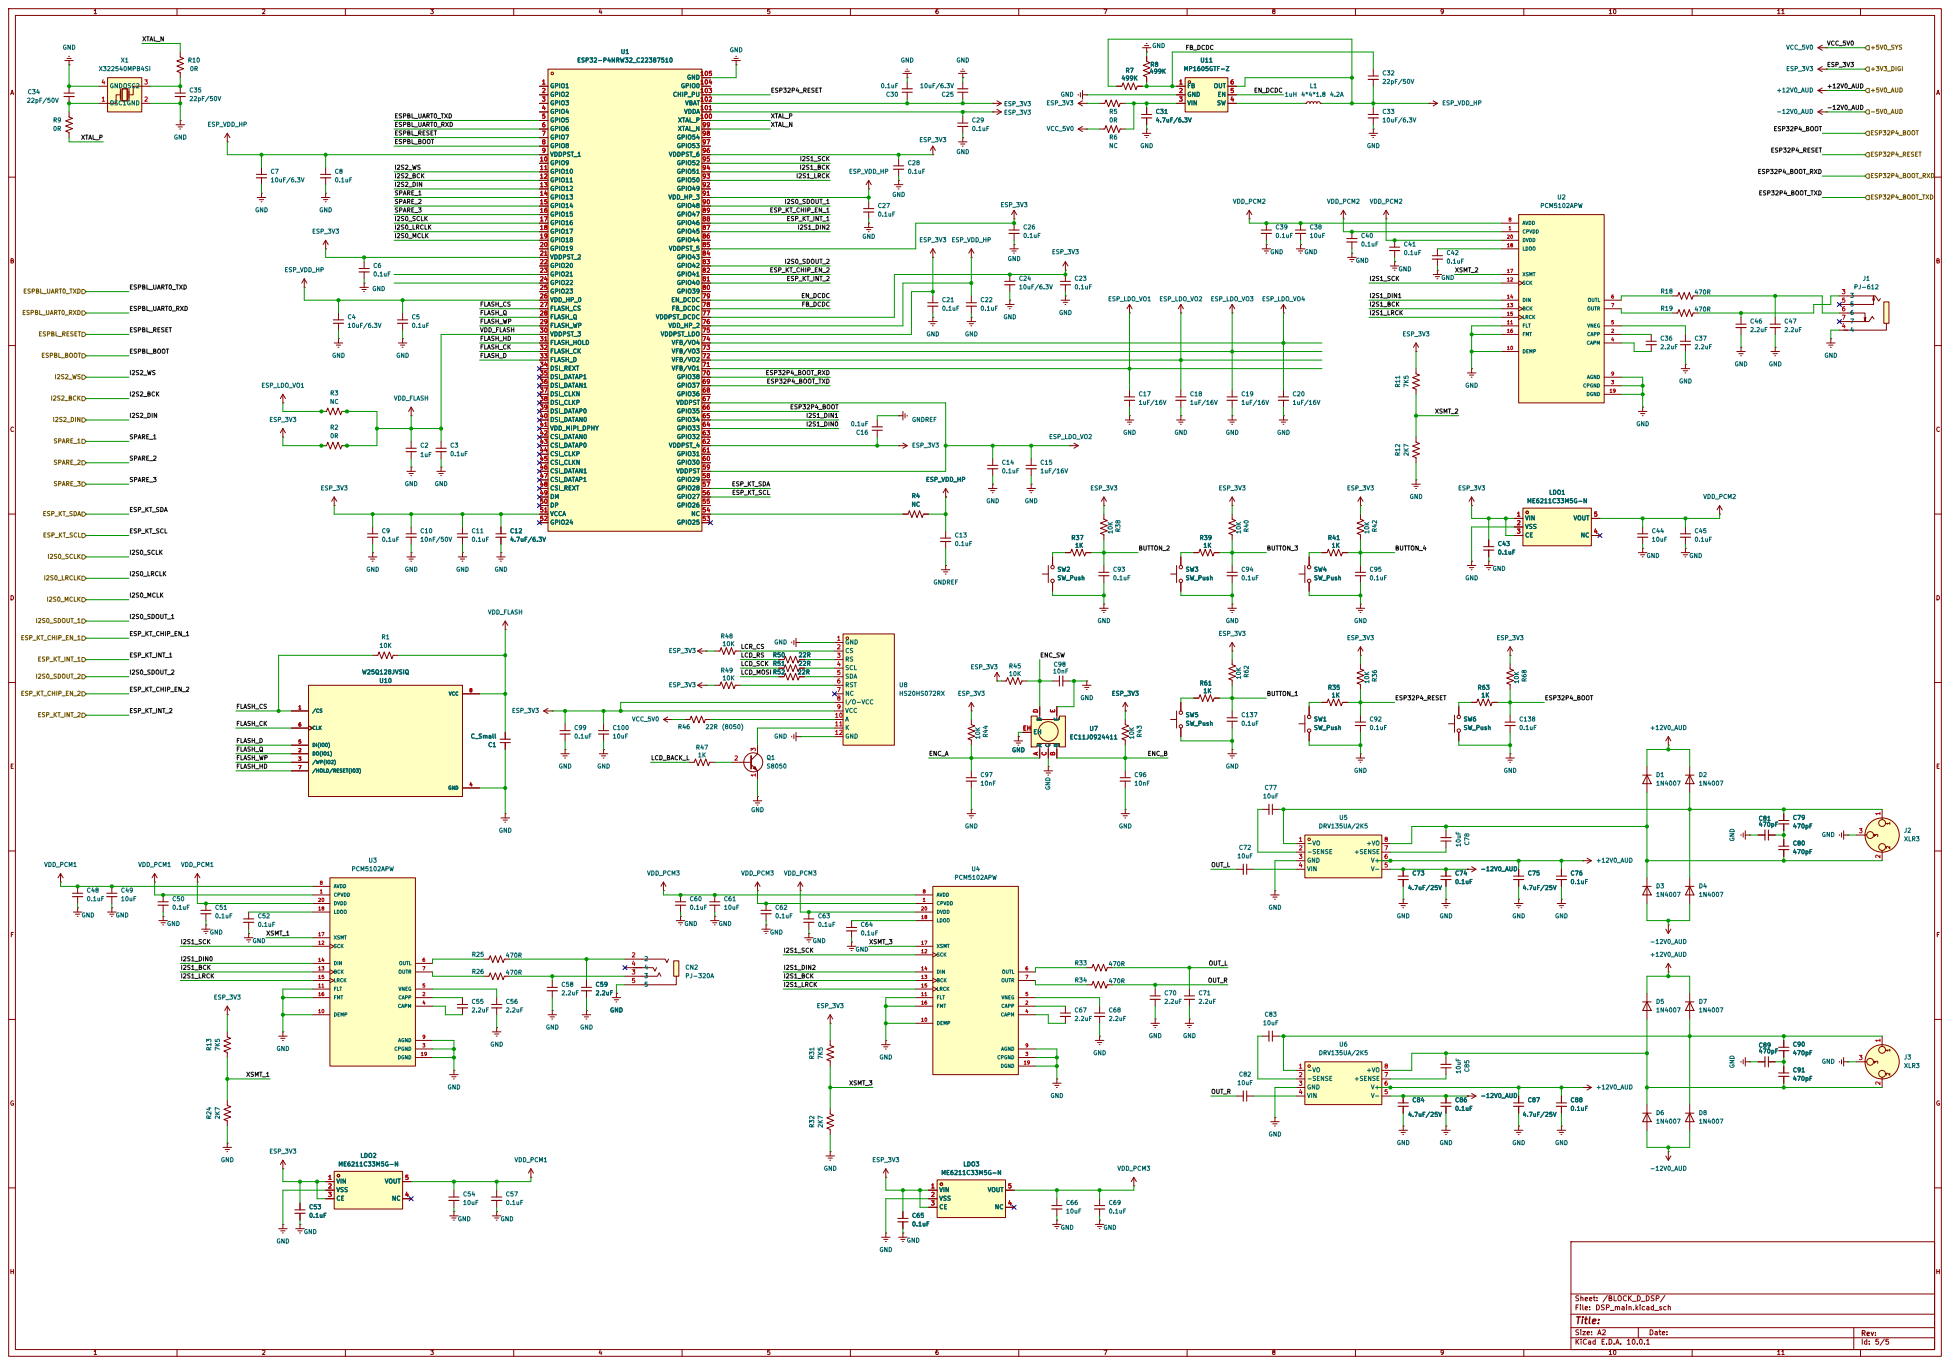
[picture p16: page 5]
