LarryVan-engin/PJC_MIC/FOX_M4_Prototype_v1.0-BLOCK_B_MIC_INPUT.pdf

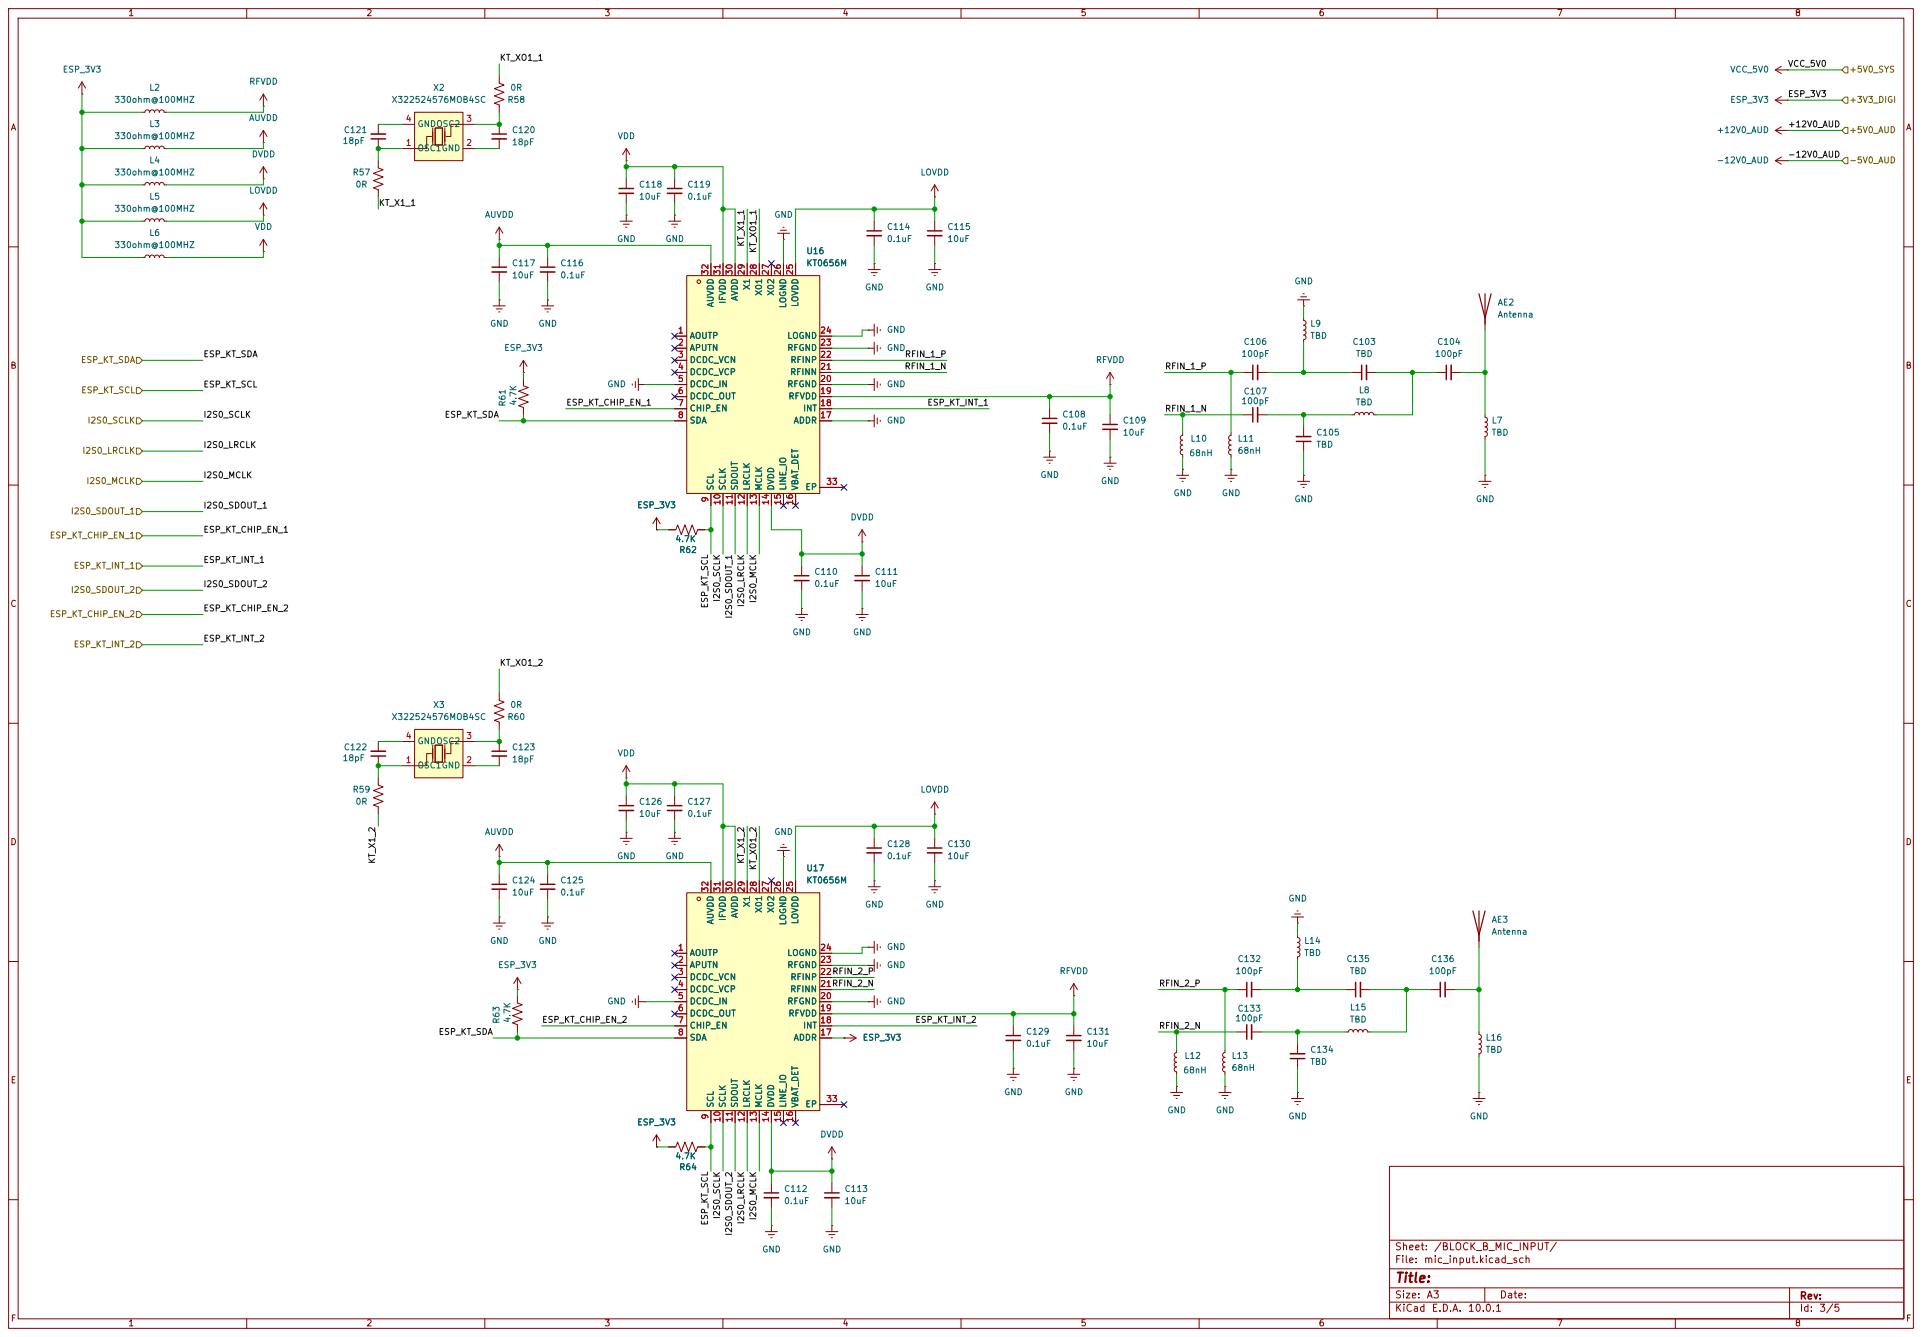
[picture p17: page 1]

Size: A3 | Rev: | F Date:
KiCad E.D.A. 10.0.1 | Id: 3/5
