LarryVan-engin/PJC_MIC/FOX_M4_Prototype_v1.0-BLOCK_D_DSP.pdf

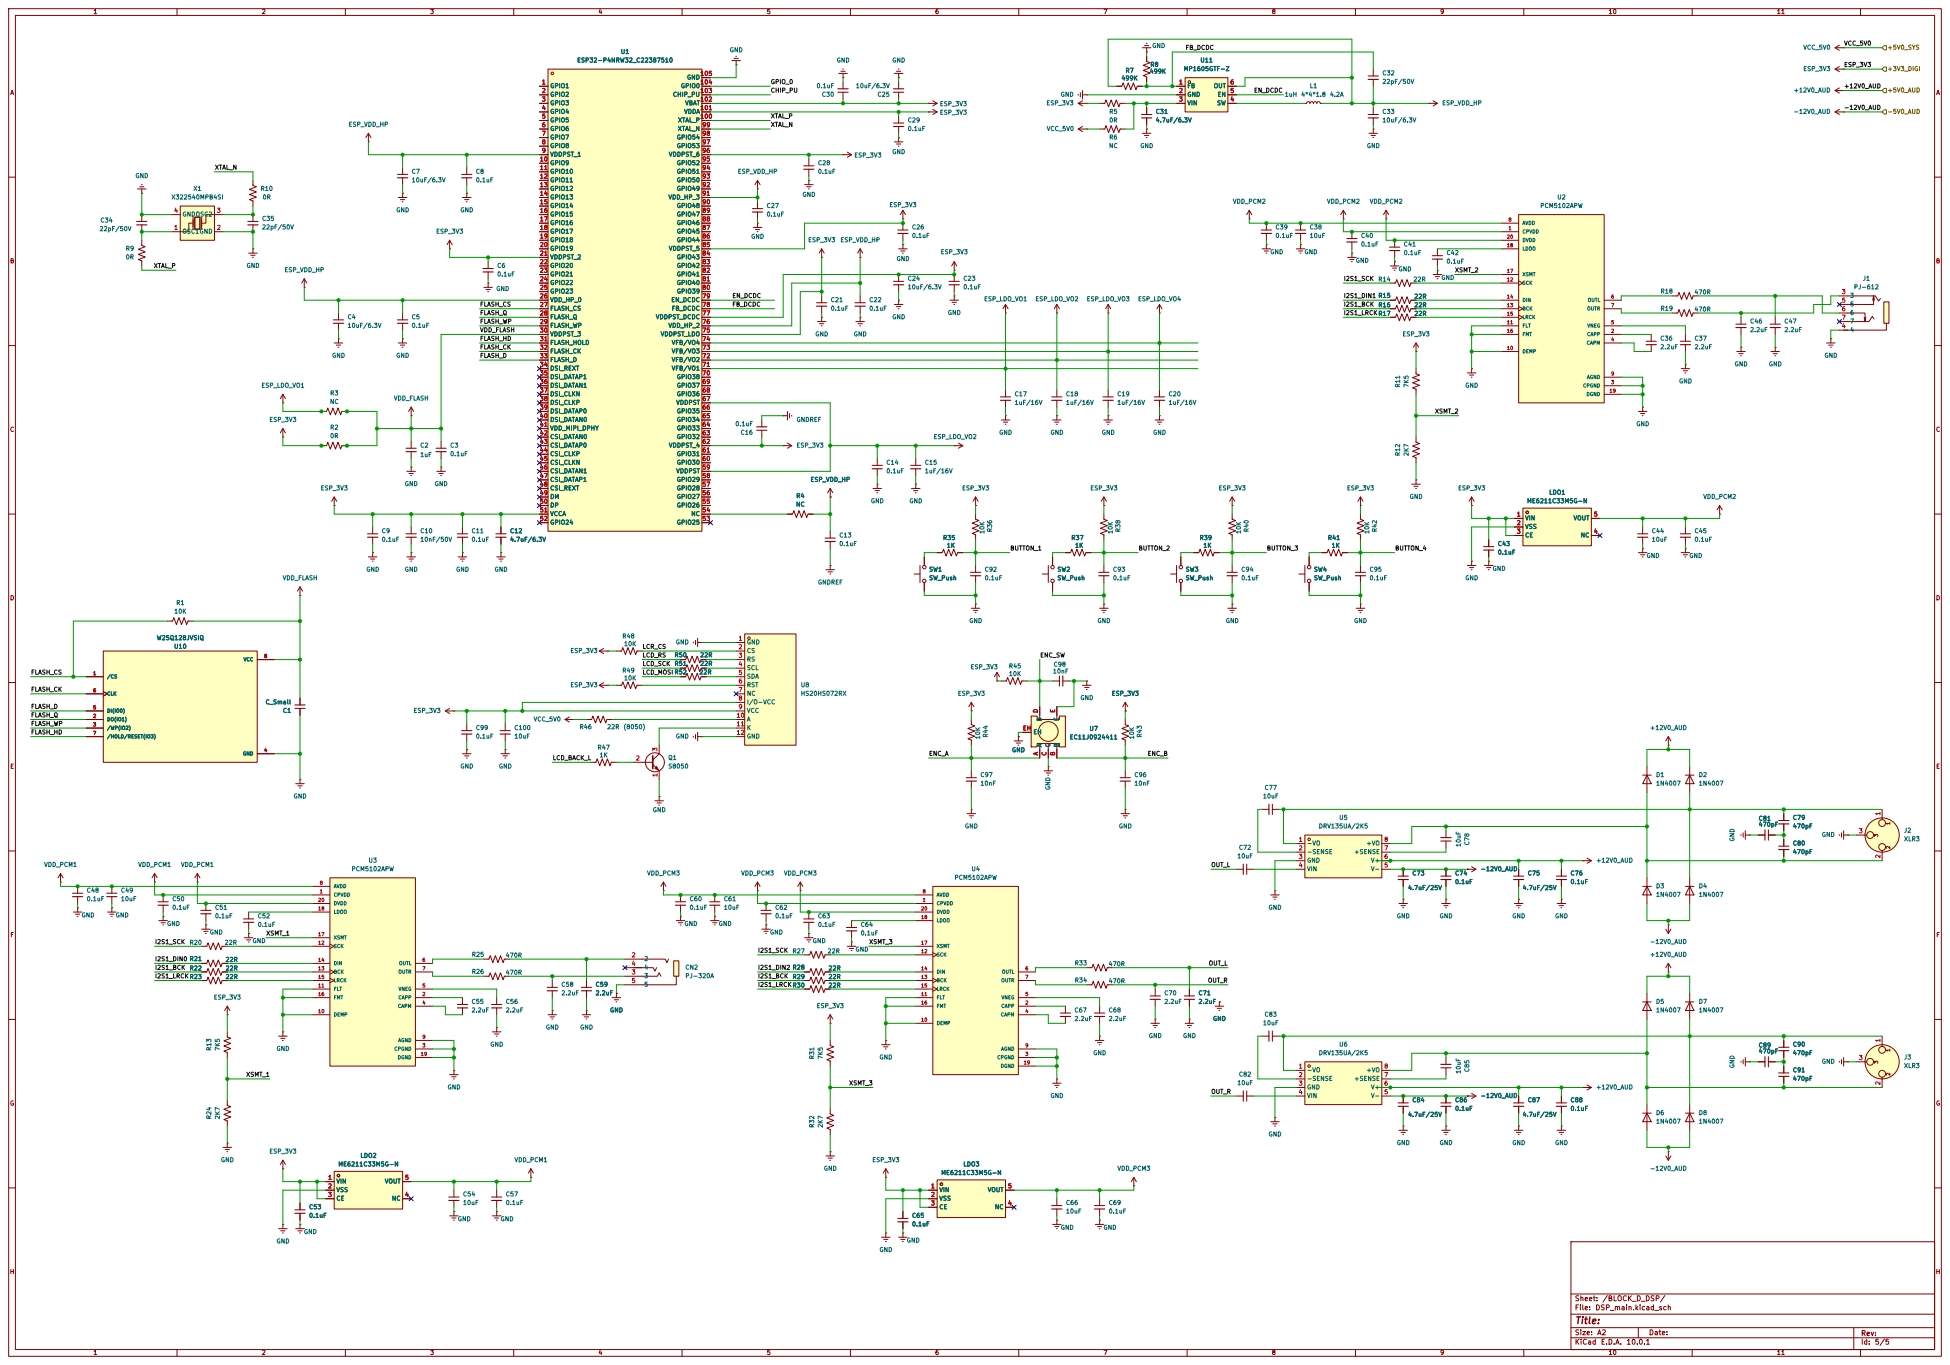
[picture p18: page 1]

Size: A2 | Rev:
KiCad E.D.A. 10.0.1 | Id: 5/5
